SteveMayze/FieldDevice_Power/doc/SampleApplication.png

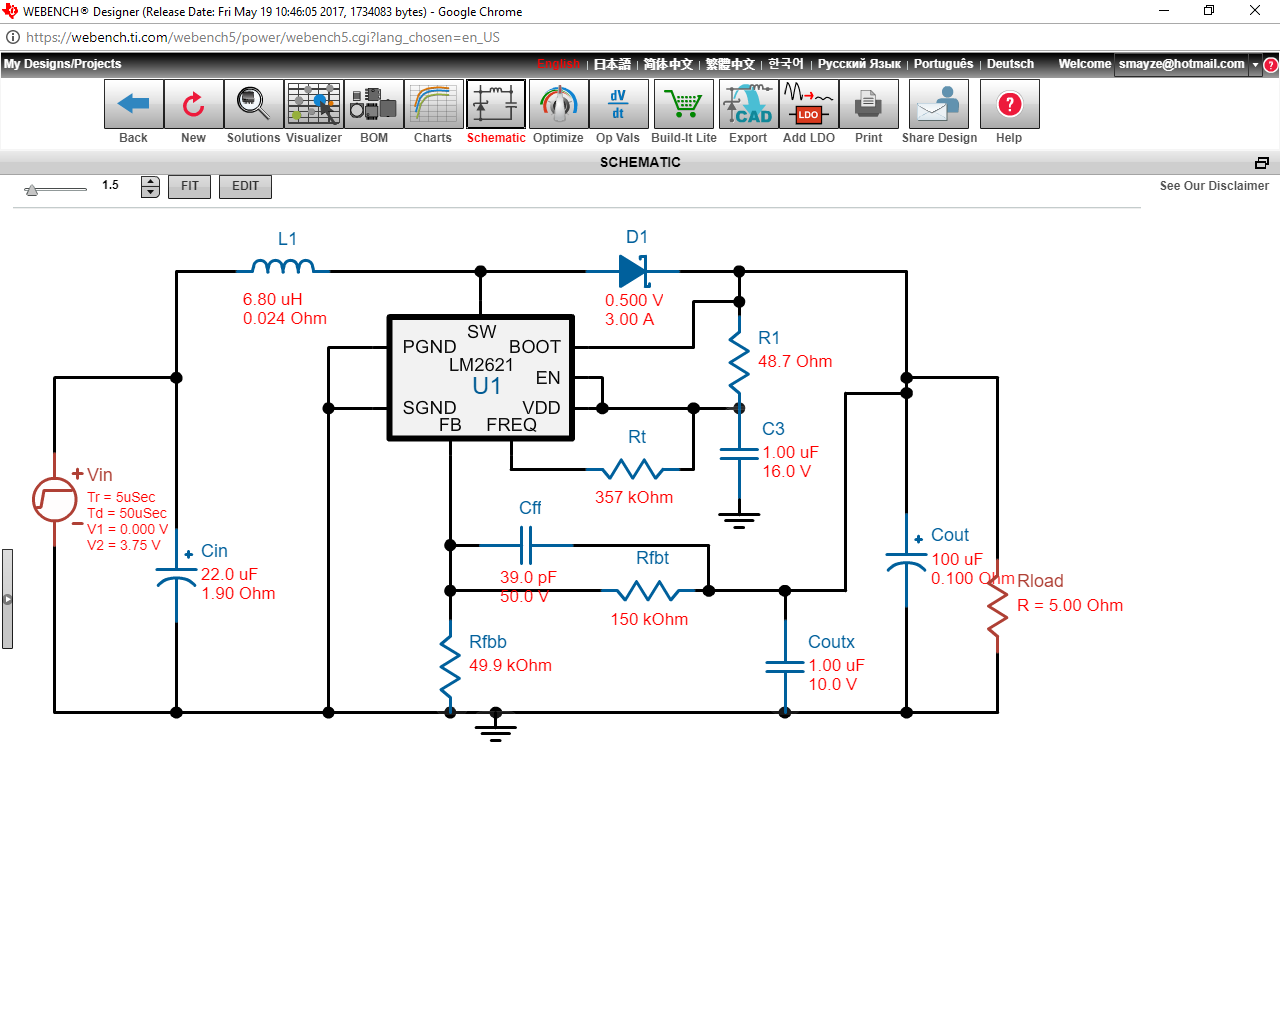
doc/SampleApplication.png
