SteveMayze/FieldDevice_Power/doc/SampleApplication_kicad.png

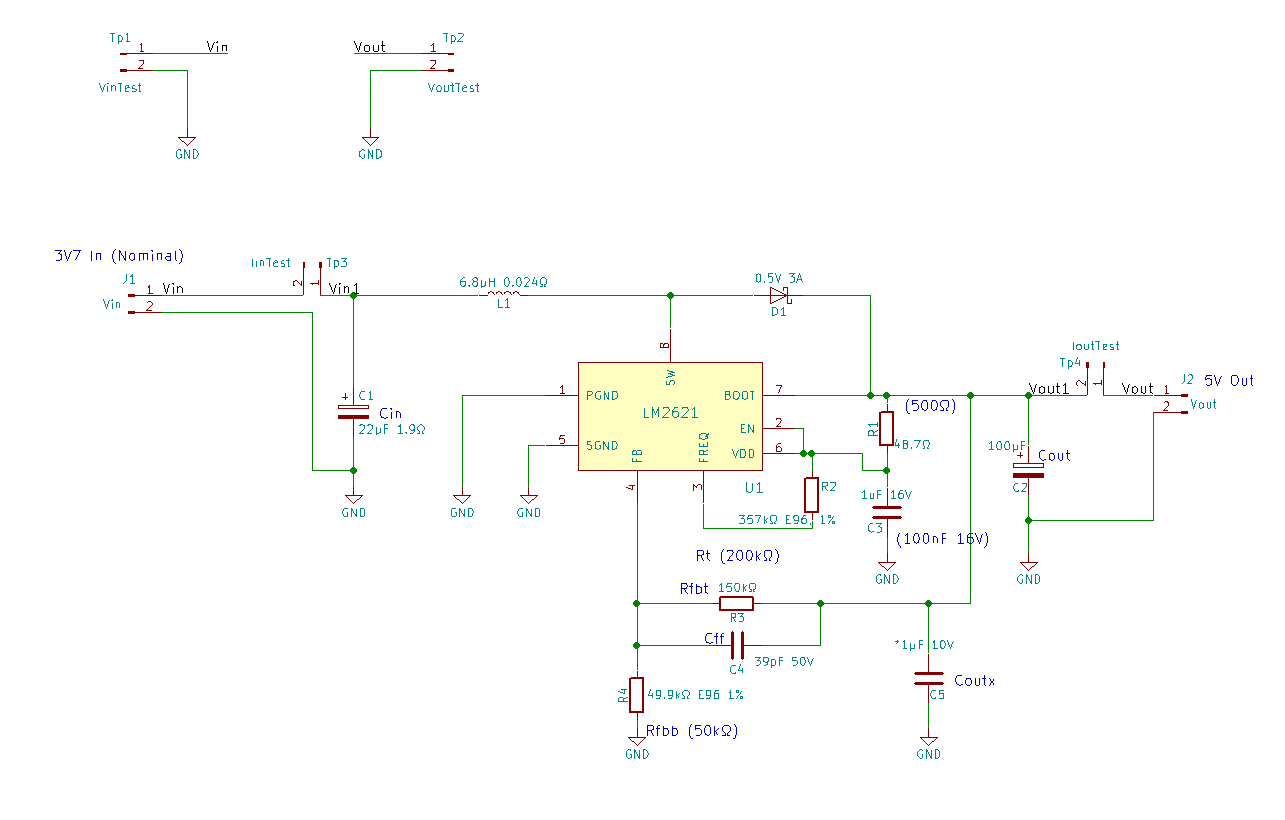
doc/SampleApplication_kicad.png
