SteveMayze/FieldDevice_Power/doc/SampleApplication_Layout.png

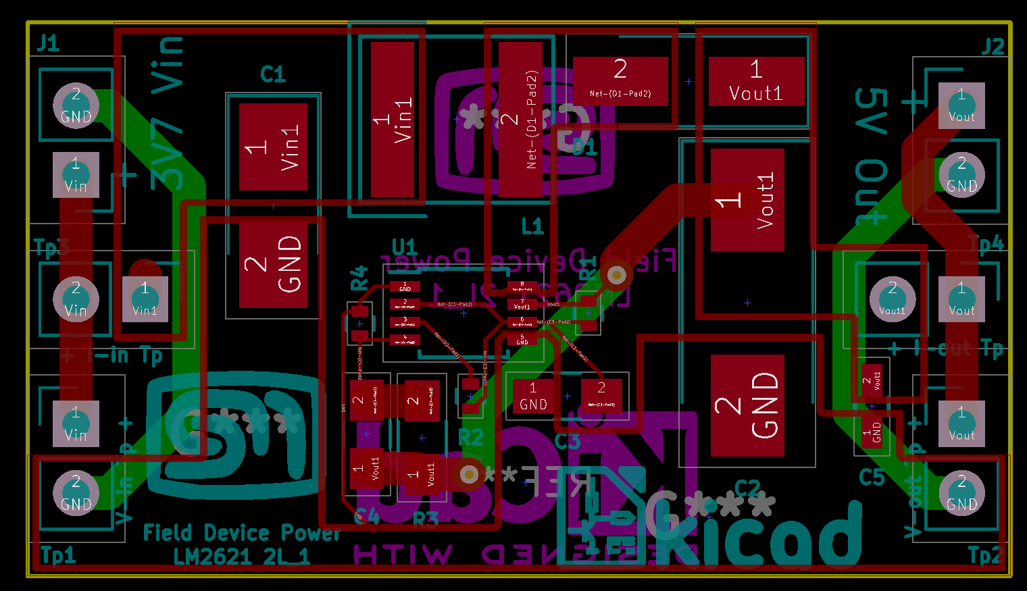
doc/SampleApplication_Layout.png
