SteveMayze/FieldDevice_Power/doc/BOM_4530725_13.ods

Part | Attribute 1 Value | Attribute 3 Value | Footprint
C3 | 1uF |  | 0805
Cff | 39pF |  | 0805
Cin | 22uF |  | 3528-21
Cout | 100uF |  | 7343-31
Coutx | 1uF |  | 0603
D1 | 0.5V | 20V | SMA
L1 | 6.8uH | 3.6A | VLP8040
R1 | 48.7Ohm | 0.063W | 0402
Rfbb | 49.9kOhm | 0.063W | 0402
Rfbt | 150kOhm | 0.1W | 0805
Rt | 357kOhm | 0.063W | 0402
U1 |  |  | MUA08A
