SteveMayze/FieldDevice_Power/pcb/FieldDevice_Power.kicad_pcb

## KiCad design pcb/FieldDevice_Power.kicad_pcb (2017-11-01)

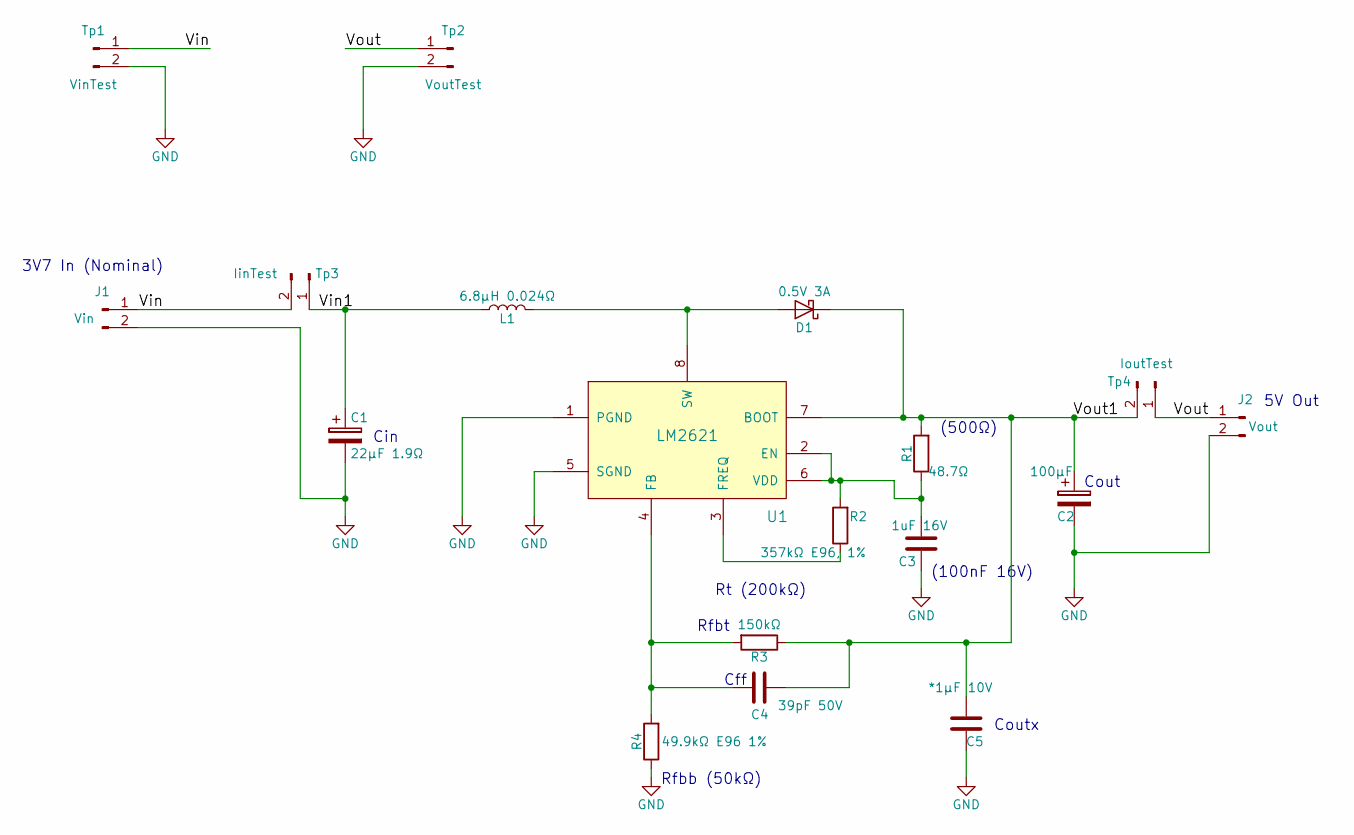
[picture p4: schematic FieldDevice_Power.sch]

Parts:
C1: 22μF 1.9Ω; CP_Tantalum_Case-B_EIA-3528-21_Hand; MPN 293D226X9016B2TE3
C2: 100μF; CP_Tantalum_Case-D_EIA-7343-31_Hand; MPN 593D107X0010D2TE3
C3: 1uF 16V; C_0805_HandSoldering; MPN EMK212B7105KG-T
C4: 39pF 50V; C_0805_HandSoldering; MPN CC0805JRNPO9BN390
C5: *1μF 10V; C_0603_HandSoldering; MPN C0603C105Z8VACTU
D1: 0.5V 3A; D_SMA_Handsoldering; MPN B320A-13-F
J1: Vin; Pin_Header_Straight_1x02_Pitch2.54mm
J2: Vout; Pin_Header_Straight_1x02_Pitch2.54mm
L1: 6.8μH 0.024Ω; INDUCTOR_1255AY-6R8M=P3; MPN 1255AY-6R8M=P3
R1: 48.7Ω; R_0402; MPN CRCW040248R7FKED
R2: 357kΩ E96, 1%; R_0402; MPN CRCW0402357KFKED
R3: 150kΩ; R_0805_HandSoldering; MPN RR1220P-154-D
R4: 49.9kΩ E96 1%; R_0402; MPN RC0402FR-0749K9L
Tp1: VinTest; Pin_Header_Straight_1x02_Pitch2.54mm
Tp2: VoutTest; Pin_Header_Straight_1x02_Pitch2.54mm
Tp3: IinTest; Pin_Header_Straight_1x02_Pitch2.54mm
Tp4: IoutTest; Pin_Header_Straight_1x02_Pitch2.54mm
U1: LM2621; TSSOP-8_3x3mm_Pitch0.65mm; MPN LM2621MM/NOPB

Connections:
/Vin: J1.1, Tp1.1, Tp3.2
/Vin1: C1.1, L1.1, Tp3.1
/Vout: J2.1, Tp2.1, Tp4.1
/Vout1: C2.1, C4.1, C5.2, D1.1 (K), R1.2, R3.1, Tp4.2, U1.7 (BOOT)
GND: C1.2, C2.2, C3.1, C5.1, J1.2, J2.2, R4.1, Tp1.2, Tp2.2, U1.1 (PGND), U1.5 (SGND)
unnamed: C3.2, R1.1, R2.2, U1.2 (EN), U1.6 (VDD)
unnamed: C4.2, R3.2, R4.2, U1.4 (FB)
unnamed: D1.2 (A), L1.2, U1.8 (SW)
unnamed: R2.1, U1.3 (FREQ)

Notes on the sheet:
Rt (200kΩ)
(100nF 16V)
(500Ω)
Rfbb (50kΩ)
Cout
Coutx
Cff
Rfbt
Cin
5V Out
3V7 In (Nominal)

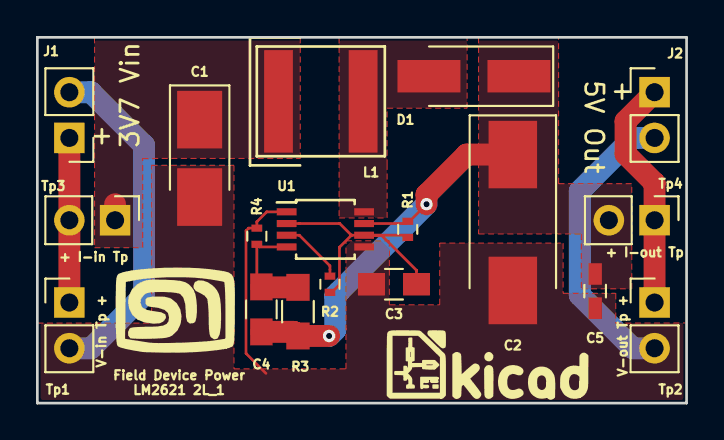
[picture p5: board FieldDevice_Power.kicad_pcb from above]

Board: 2 copper layers, 36.1 x 20.3 mm, 18 parts (0 on the bottom side), 9 nets.
