SteveMayze/FieldDevice_Power/doc/FiedDevice_Power_DischargeTest.ods

Time | Batt Voltage | Load Current
10:36:00 | 3.93 | 73.90
10:37:00 | 3.92 | 73.90
10:38:00 | 3.90 | 73.90
10:39:00 | 3.88 | 73.90
10:40:00 | 3.87 | 74.00
10:41:00 | 3.85 | 74.00
10:42:00 | 3.84 | 74.00
10:43:00 | 3.83 | 74.00
10:44:00 | 3.82 | 74.00
10:45:00 | 3.81 | 74.00
10:46:00 | 3.80 | 74.00
10:47:00 | 3.79 | 74.00
10:48:00 | 3.78 | 74.00
10:49:00 | 3.77 | 74.00
10:50:00 | 3.77 | 74.10
10:51:00 | 3.76 | 74.00
10:52:00 | 3.76 | 74.00
10:53:00 | 3.75 | 74.00
10:54:00 | 3.74 | 74.10
10:55:00 | 3.73 | 74.10
10:56:00 | 3.73 | 74.00
10:57:00 | 3.72 | 74.10
10:58:00 | 3.71 | 74.10
10:59:00 | 3.71 | 74.00
11:00:00 | 3.70 | 74.10
11:01:00 | 3.69 | 74.00
11:02:00 | 3.69 | 74.10
11:03:00 | 3.68 | 74.10
11:04:00 | 3.68 | 74.00
11:05:00 | 3.67 | 74.10
11:06:00 | 3.67 | 74.10
11:07:00 | 3.66 | 74.00
11:08:00 | 3.66 | 74.10
11:09:00 | 3.65 | 74.00
11:10:00 | 3.65 | 74.10
11:11:00 | 3.64 | 74.10
11:12:00 | 3.64 | 74.10
11:13:00 | 3.63 | 74.10
11:14:00 | 3.63 | 74.10
11:15:00 | 3.62 | 74.10
11:16:00 | 3.62 | 74.10
11:17:00 | 3.61 | 74.10
11:18:00 | 3.61 | 74.20
11:19:00 | 3.60 | 74.00
11:20:00 | 3.60 | 74.10
11:21:00 | 3.59 | 74.00
11:22:00 | 3.59 | 74.10
11:23:00 | 3.59 | 74.10
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
