SteveMayze/FieldDevice_Power/(commit log)

2017-10-31 First commit - including initial schematic and a start on the layout
    [BOM_4530725_13.ods, BOM_4530725_13.xls, FieldDevice_Power.kicad_pcb, FieldDevice_Power.sch]
2017-10-31 Added the pin headers for Vin and Vout
    [FieldDevice_Power.kicad_pcb, FieldDevice_Power.sch]
2017-11-01 Completed the layout and parts decisions
    [FieldDevice_Power-B.Cu.gbr, FieldDevice_Power-B.Mask.gbr, FieldDevice_Power-B.SilkS.gbr, FieldDevice_Power-Edge.Cuts.gbr, FieldDevice_Power-F.Cu.gbr, FieldDevice_Power-F.Mask.gbr, FieldDevice_Power-F.Paste.gbr, FieldDevice_Power-F.SilkS.gbr]
2017-11-01 Updated a replacement for R4
    [FieldDevice_Power.kicad_pcb, FieldDevice_Power.sch]
2017-11-26 Researching options for the charger and buckboost converter
    [FiedDevice_Power_DischargeTest.ods]
